cmordinibluhm/glove_mouse/assets/glove_close_up.jpg

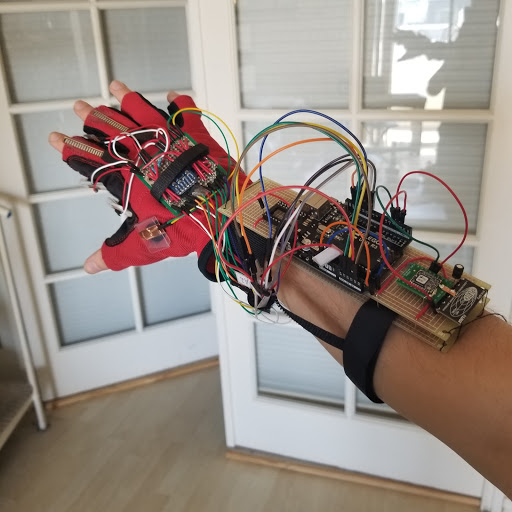
assets/glove_close_up.jpg
